freetronics/MicrophoneSoundModule/_rewrite_README.md

Freetronics ProtoShieldShort
==============================
Copyright 2011 Freetronics Pty Ltd  
Freetronics site:  <www.freetronics.com>  
Freetronics email: <info@freetronics.com>  

A special short prototyping shield for the Arduino, designed to be able
to clear the RJ45 jack on an Ethernet Shield or Freetronics EtherTen.

Note that this design is intended for simple fabrication and assembly,
and does not have many of the features of other prototyping shields
such as the "ProtoShield" (also available from Freetronics) such as
general-purpose LEDs.

Features:

 * Pads for reset button connected to Arduino reset pin.
 * Parts overlay on both the top and the bottom so you can see what you
   are connecting without having to keep turning the board over.

More information is available at:

  http://www.freetronics.com/protoshield-short

The "docs" folder within this repository includes a handy copy of the
schematic in PDF format and image(s) of the pcb.

INSTALLATION
------------
The design is saved as an EAGLE project. EAGLE PCB design software is
available from www.cadsoftusa.com free for non-commercial use. To use
this project download it and place the directory containing these files
into the "eagle" directory on your computer. Then open EAGLE and
navigate to Projects -> eagle -> ProtoShieldShort.

DISTRIBUTION
------------
The specific terms of distribution of this project are governed by the
license referenced below.

LICENSE
-------
Licensed under the TAPR Open Hardware License (www.tapr.org/OHL).
The "license" folder within this repository also contains a copy of
this license in plain text format.
