freetronics/MicrophoneSoundModule/MIC_MicrophoneSoundModule.pdf

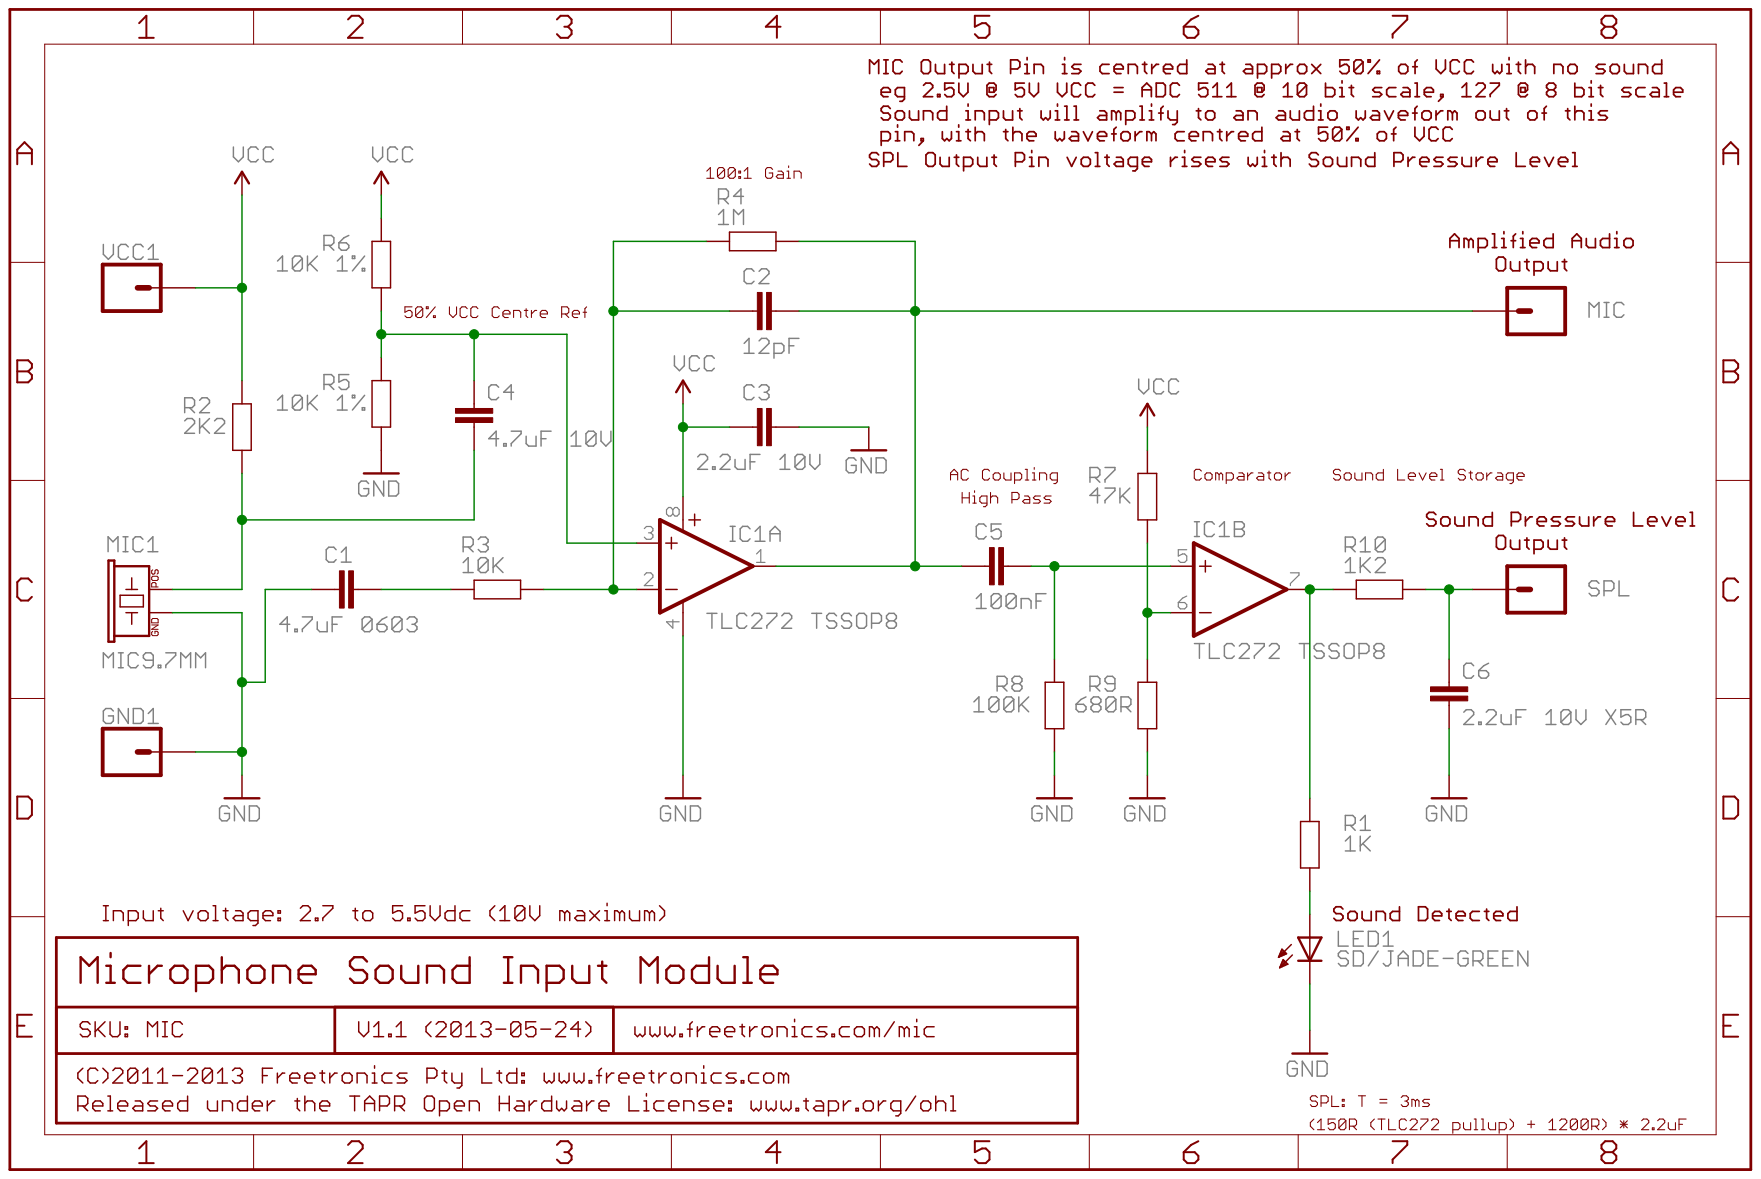
[picture p1: page 1]
