freetronics/MicrophoneSoundModule/MicrophoneSoundModule.brd

## EAGLE design MicrophoneSoundModule.brd (2013-05-24)

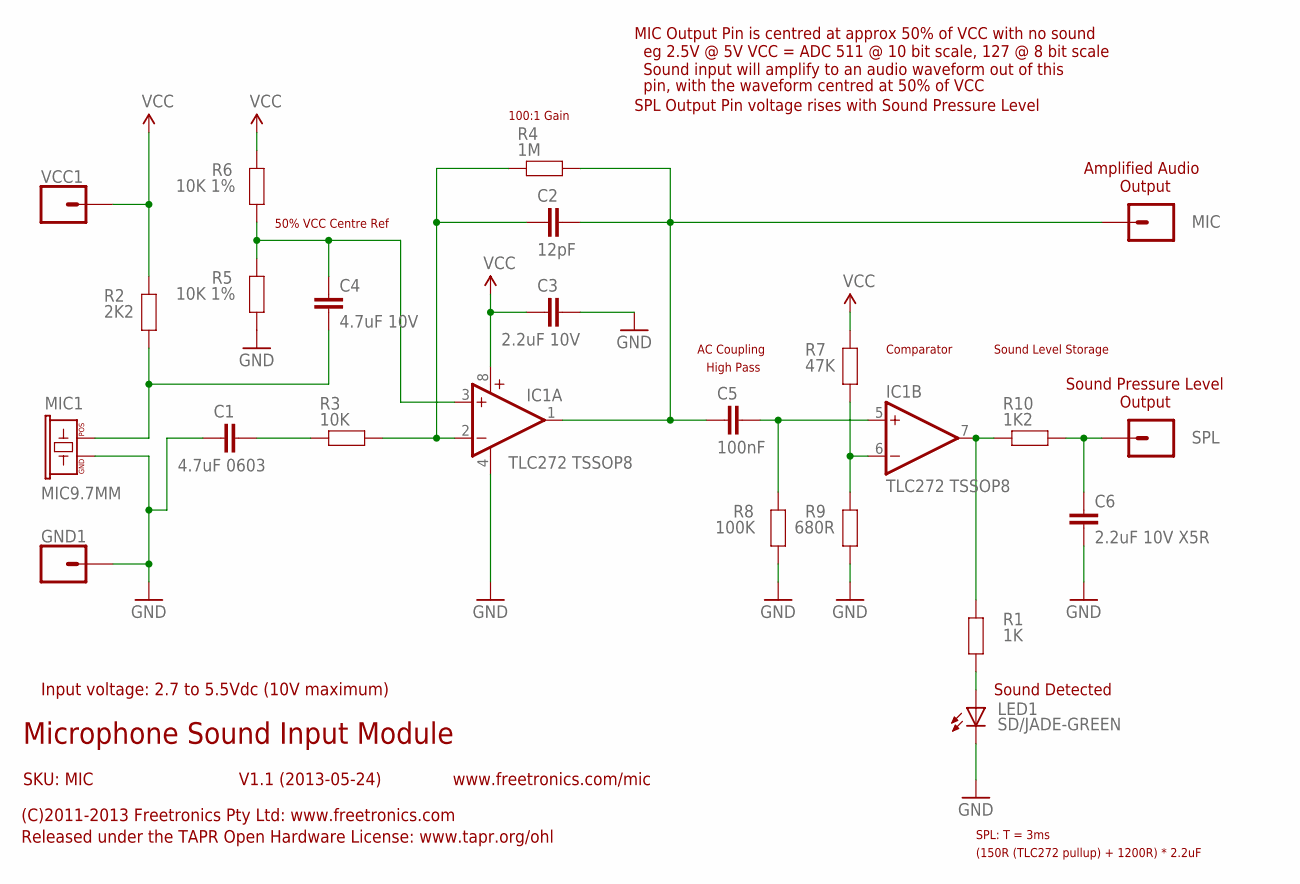
[picture p2: schematic MicrophoneSoundModule.sch]

Parts:
C1: 4.7uF 0603; 0603
C2: 12pF; 0603
C3: 2.2uF 10V; 0603
C4: 4.7uF 10V; 0603
C5: 100nF; 0603
C6: 2.2uF 10V X5R; 0603
GND1: M01PTH; 1X01
IC1: TLC272 TSSOP8; TSSOP8
LED1: SD/JADE-GREEN; LED-0603
MIC: M01PTH; 1X01
MIC1: MIC9.7MM; MIC-9.7MM
R1: 1K; 0603
R2: 2K2; 0603
R3: 10K; 0603
R4: 1M; 0603
R5, R6: 10K 1%; 0603
R7: 47K; 0603
R8: 100K; 0603
R9: 680R; 0603
R10: 1K2; 0603
SPL: M01PTH; 1X01
VCC1: M01PTH; 1X01

Connections:
GND: C1.1, C3.2, C6.1, GND1.1, IC1.4 (V-), LED1.C, MIC1.GND, R5.1, R8.1, R9.1
unnamed: LED1.A, R1.1
unnamed: C4.1, MIC1.POS, R2.1
unnamed: C1.2, R3.2
unnamed: C2.1, IC1.2 (-IN), R3.1, R4.2
unnamed: C2.2, C5.1, IC1.1 (OUT), MIC.1, R4.1
unnamed: C5.2, IC1.5 (+IN), R8.2
unnamed: C4.2, IC1.3 (+IN), R5.2, R6.1
unnamed: C6.2, R10.1, SPL.1
unnamed: IC1.6 (-IN), R7.1, R9.2
unnamed: IC1.7 (OUT), R1.2, R10.2
VCC: C3.1, IC1.8 (V+), R2.2, R6.2, R7.2, VCC1.1

Notes on the sheet:
Microphone Sound Input Module
V1.1 (2013-05-24)
SKU: MIC
(C)2011-2013 Freetronics Pty Ltd: www.freetronics.com
Released under the TAPR Open Hardware License: www.tapr.org/ohl
www.freetronics.com/mic
Input voltage: 2.7 to 5.5Vdc (10V maximum)
50% VCC Centre Ref
100:1 Gain
MIC Output Pin is centred at approx 50% of VCC with no sound
eg 2.5V @ 5V VCC = ADC 511 @ 10 bit scale, 127 @ 8 bit scale
Sound input will amplify to an audio waveform out of this
pin, with the waveform centred at 50% of VCC
Amplified Audio
Comparator
AC Coupling
High Pass
Sound Level Storage
Sound Pressure Level
Output
Sound Detected
SPL Output Pin voltage rises with Sound Pressure Level
SPL: T = 3ms
(150R (TLC272 pullup) + 1200R) * 2.2uF

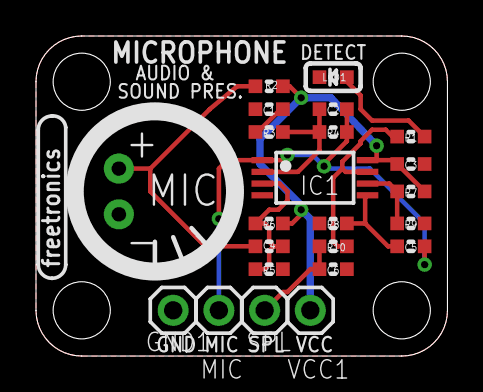
[picture p3: board MicrophoneSoundModule.brd from above]

Board: 2 copper layers, 22.9 x 17.8 mm, 23 parts (0 on the bottom side), 12 nets.
