freetronics/MicrophoneSoundModule/(threads)

Thread 1 (2016-02-10):

Midpoint voltage is too high

projectgus, 2016-02-10:
As noted here:
http://forum.freetronics.com/viewtopic.php?f=15&t=6520

Zero DC offset should be closed to 38% of VCC, in order to avoid clipping the audio output high side before the low side. Or consider swapping to a fully rail-to-rail op amp.
