freetronics/MicrophoneSoundModule/(commit log)

2011-10-13 First push, pcb underway
    [MicrophoneSoundModule.brd, MicrophoneSoundModule.sch]
2011-10-13 pcb in progress
    [MicrophoneSoundModule.brd, MicrophoneSoundModule.sch]
2011-10-14 pcb nearly complete
    [MicrophoneSoundModule.brd, MicrophoneSoundModule.sch]
2011-10-14 v1.0 release
    [MicrophoneSoundModule.brd, MicrophoneSoundModule.sch]
2011-12-12 Schematic and Reference PDF renamed
2013-05-24 Update to EAGLE 6.4
    [MicrophoneSoundModule.brd, MicrophoneSoundModule.sch]
2013-05-24 Reorient AC decoupling capacitors to reduce noise
    [MicrophoneSoundModule.brd, MicrophoneSoundModule.sch]
2013-05-24 Bump revision, add revision to PCB, update schematic PDF
    [MicrophoneSoundModule.brd, MicrophoneSoundModule.sch]
