freetronics/MicrophoneSoundModule/(notices)

Notices in the files:
MicrophoneSoundModule.brd:
(C)2013 Freetronics Pty Ltd
